THW1/orchid-pot/examples/orchid_box.stl

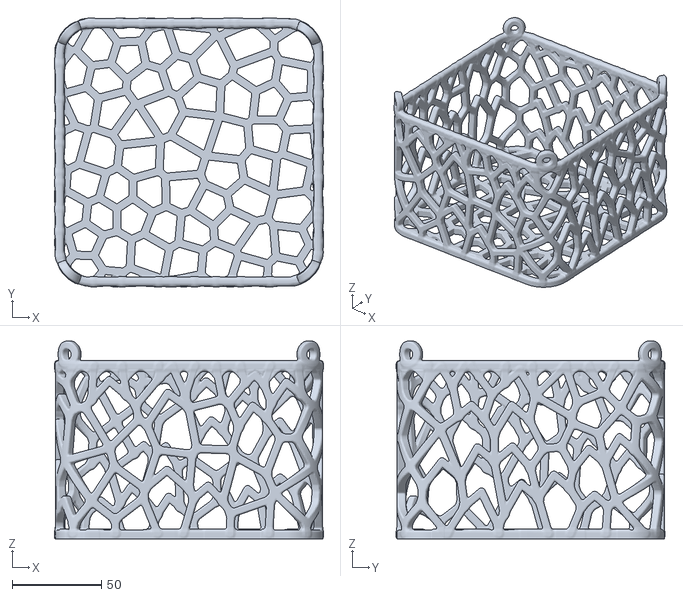
[picture p3: CAD file, 2026-10-25]
examples/orchid_box.stl
150.9 x 150.8 x 111.0
