THW1/orchid-pot/examples/orchid_cylinder_membrane.stl

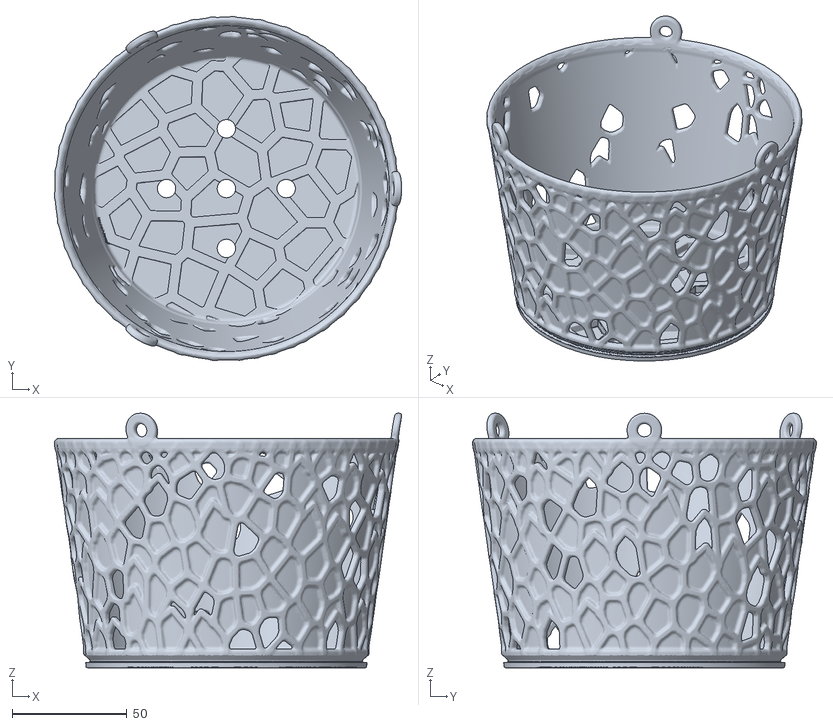
[picture p4: CAD file, 2026-10-25]
examples/orchid_cylinder_membrane.stl
151.4 x 149.9 x 110.9
