THW1/orchid-pot/examples/orchid_cylinder_membrane_tray_clip.stl

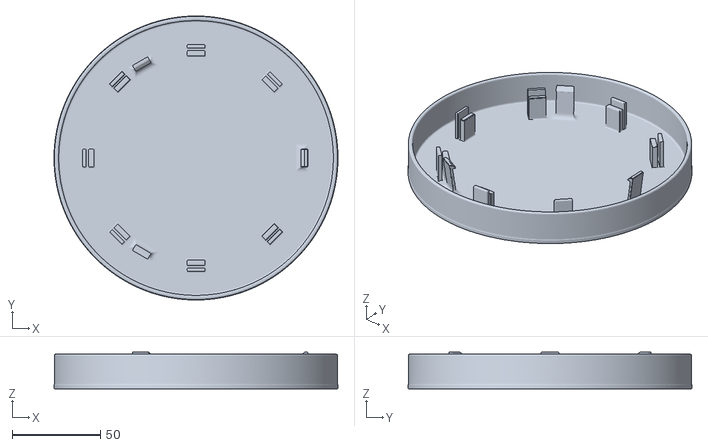
[picture p5: CAD file, 2026-10-25]
examples/orchid_cylinder_membrane_tray_clip.stl
161.3 x 161.3 x 20.9
