THW1/orchid-pot/(commit log)

2026-10-15 Add Voronoi orchid basket generator (v4)
    Parametric generator for a printable Vanda-style hanging orchid basket
    (PETG, 0.4 mm nozzle, printed upright without supports): planar Voronoi
    walls and floor, node lifting, pointed arches, graded cells and grown rim
    gussets against slicer cantilever warnings. Includes the Blender preview
    renderer, README, CONTEXT.md, the current STL/report/previews and the
    archived v2 3D-lattice variant.
2026-10-17 Add cylinder shape with optional taper; shape subcommands
    - CLI: shapes are subcommands (box, cylinder); shared options in a parent
    parser grouped as common / details / printability / mesh.
    - Frames: BoxFrame (rounded square, unchanged v0.4.0 math) and ConeFrame
    (cylinder or cone frustum, --taper in degrees, chart u = theta * r_ref
    with local metric factors). The pipeline only uses the frame interface.
    - --eyelets N (0 = standing pot; box default 4, cylinder default 3).
    - Taper metric taken at a strut's lower end in both lift and classify
    (a mismatch removed 34 nodes at -8 deg).
    - Fill sub-mm^3 enclosed voids after marching cubes (seen with tapers).
    - Default output prefix orchid_<sh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
2026-10-17 Move shape-independent helpers into potlib.py (no output change)
    Pure move of SDF primitives, Poisson seeding, segment distances, Grid,
    wall_metrics, floor_segments, meshing and all checks, plus the former
    main() tail as potlib.finish(). Prepares the experimental orb shape to
    reuse them without touching the box/cylinder pipeline.
    Verified: tests/ pass (box, cylinder, cylinder --taper 8 byte-identical).
2026-10-17 Add experimental orb shape (onion) in its own module
    - orb.py: vertically stretched ellipsoid cut where the wall angle reaches
    --min-wall-angle (default 55 deg), --stretch 1.2, --diameter 150.
    SphericalVoronoi pattern with mirrored seeds at the band/rim latitudes,
    printability on true 3D angles (meridian lift, arches, clash check),
    shell SDF via projection onto the meridian ellipse, rim gussets grown
    per voxel slice, stability check (tip-over angle).
    - orchid_pot.py: `orb` subcommand, imported lazily; --height/--zstretch
    now only for box/cylinder (derived for the orb). No output change for
    box/cylinder (tests pass byte-identical).
    - potlib.finish(): optional extra_checks hook.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
2026-10-17 Fix review findings 1-5, 7-10 (no box/cylinder output change)
    H1 orb: mirror only seeds whose polar-angle image stays beyond its anchor
    latitude; images wrapped over the pole pinned interior vertices to the
    band/rim line (--stretch 1.4 --min-wall-angle 50: 134 -> 42 anchor
    edges, 2 -> 0 removed nodes, max opening height 60 -> 40.5 mm).
    M2 all: --grade-top 0 now really disables grading (formula inverted for
    an empty range and shrank every cell; box: 511 -> 207 nodes).
    M3 orb: floor clipped at the wall's outer face (was mid radius): closes
    the ~0.85 mm groove at the floor/wall joint (+292 mm^2 at z = 4.5).
    M4 orb: arch clash test samples legs at 1 mm and exempts per leg.
    M5 CLI: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
2026-10-17 Merge rim gussets without shifting existing surfaces (review finding 6)
    The gusset SDF was built from all grown material (gusset + struts) and
    min-merged, so inside the struts the voxel/pixel-quantized field replaced
    the smooth one and pushed every surface in the rim zone ~0.2 mm outward
    (the staircase texture under the rim). Now:
    - SDF of the added gusset material only (inside the struts it is >= +1 px,
    so the smooth strut field is kept),
    - 1-voxel Gaussian blur against 1-voxel slivers/pinches where two gusset
    fronts meet (they produced a second body after STL export),
    - smooth union with the strut fillet (a hard min left creases that broke
    the decimation).
    Applies to box/cylinder (2D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
2026-10-17 Finalize code context for v0.6.1 (comments and CONTEXT.md only)
    - Unit context blocks: potlib.finish, orb.orb_graph, orb.grow_rim_gussets;
    orchid_pot.wall_pattern block extended with the shared gusset merge rule.
    - Stale header statements updated (potlib no longer a pure move; orb now
    lives in orb.py; box byte-identity held until the intended v0.6.1 change).
    - CONTEXT.md: gusset rule coupling and shared potlib helpers.
    Reference check: 21 file::symbol references, all resolve. Tests pass.
2026-10-17 Add accessories module with drip tray (saucer) for all shapes
    - accessories.py (separate module, pot pipelines untouched): tray from the
    pot's vertical projection (widest outline; orb: belly) + gap, 2.4 mm
    wall, 2 mm floor, 8 feet under the solid bottom band with outer stops
    (1 mm side clearance, offset by the band's lean), water line 1 mm below
    the pot bottom. Reads pot geometry read-only via TrayGeometry adapters.
    - CLI: --parts pot,tray (accessories only: ~5 s, no pot rebuild), --tray,
    --tray-gap, --tray-wall, --tray-floor, --standoff, --tray-rise.
    - Defaults: box 117 ml / 87 g, cylinder 93 ml / 72 g, orb 92 ml / 73 g;
    all watertight, 1 body, 0 islands, no cantilevers.
    - Fit v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
2026-10-17 Add clip-on tray for hanging pots; STL round-trip check
    - accessories: --tray clip. Flexible arms beside the bottom band, hooks
    over the band top into lattice gaps found from the pot's strut paths
    (main passes wall_graph/orb_graph output for the same seed). Hook reach
    measured past the band's edge rounding (1.5 mm in the wall normal,
    1.5*band_w/wall horizontally) onto the flat top; catch face above the
    real band top (band/floor smooth-union bulge measured 5.46-5.72 mm).
    Standoff auto-chosen for <= 2 % arm strain (box/cylinder 9.9, orb 11.1).
    Feet next to clips dropped; tray gap widened if the arm could not flex.
    Output: <out>_tray_clip.stl (saucer keeps <out>_tray.stl, unchan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
2026-10-17 Match accessories to their pot: fingerprints, automatic fit check, --from-report
    - potlib.fingerprint: 'shape' (outline/band parameters) and 'pattern' (hash
    of the strut paths, 1 um) written into pot and tray reports.
    - accessories.fit_checker: if the pot STL/report sit next to the tray,
    compare fingerprints, then mesh-intersection fit check (seated: no
    overlap; clip: all hooks engage at 1.5 mm lift). Mismatch -> error exit
    with a --from-report hint; missing pot -> skipped and noted.
    - --from-report REPORT: take all pot parameters (and --out) from a pot's
    report; accessory and run options stay from the CLI.
    - potlib.export_safe: if the float32 STL round trip breaks a mesh (box
    --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
2026-10-17 Add planter (closed outer pot; orb: bowl) to accessories
    - --parts planter: inner wall = insertion envelope (widest pot outline
    below each height) + --planter-gap 8, wall 2.4 mm normal to the wall,
    floor 2 mm, feet under the band (6 mm standoff, 5 mm reservoir), 4
    centring ribs (1 mm clearance, 45 deg lead-in). Box/cylinder flush with
    the pot rim; taper < 0 automatically a straight cylinder; orb: bowl up to
    the belly. Optional --planter-eyelets for hanging planters.
    - Fit check extended: seated no overlap + sliding-in test (no overlap at
    10/30/60 mm above the seated position). All pass: box, cylinder, taper
    +8 and -8 (via --from-report), orb bowl; box with 4 eyelets.
    - Measured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
2026-10-17 Fix review findings M1-M4, L5-L10 and minor notes (accessories)
    M1 fit check uses the exact pot height (rounded report value made a
    correct tray fail: --tray-floor 1.25 -> 8.44 mm^3 false overlap).
    M2 hook reach from the signed band lean (taper < 0 lost 0.7 mm onto the
    edge rounding); arm placed at the band's widest face below the hook,
    tip at its top edge, snap deflection = difference (taper -8: 2.82 mm,
    standoff auto 12.4, strain 1.99 %).
    M3 clip placement checked against the strut paths over the whole hook
    height (>= 1.5 mm to every strut surface), also without the pot STL.
    M4 fit check counts engaged clips per clip (pieces -> nearest clip).
    L5 band-top allowance derived fr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
2026-10-17 Planter wall default 2.4 -> 2.0 mm
    2.0 mm is ~5 lines at 0.42 mm, the upper end of the 4-5 perimeters
    recommended for watertight PETG walls. Weights: box 290 -> 256 g,
    cylinder 245 -> 215 g, orb bowl 147 -> 130 g; reservoirs unchanged.
    All three planters: watertight after STL round trip, 1 body, 0 islands,
    fit check ok (seated + sliding in). Tests pass.
2026-10-17 Finalize code context for v0.8.1 (comments, CONTEXT.md, one shared constant)
    - Unit context blocks: accessories.TrayGeometry, place_clips, fit_checker;
    potlib.fingerprint; orchid_pot.apply_report.
    - CLIP_LIP_H replaces the hook height literal used twice (place_clips
    clearance check, tray_sdf geometry); output-neutral (clip trays
    byte-identical).
    - CONTEXT.md: adapter/hook-region/prefix relationships; Verified-at.
    - README: cylinder clip-tray figures (171 ml / 84 g) after re-placement.
    Reference check: 34 file::symbol references, all resolve.
2026-10-18 Refuse ignored accessory options; play-based clip lift test
    A run with --clip-* but the default --tray saucer silently built a tray
    without clips (reported from a real print). Now:
    - --clip-* without --tray clip / tray in --parts, --tray-* without tray,
    --planter-* without planter, --standoff without tray/planter: error.
    - --clip-hook longer than the flat band top is refused (wall 4: max 1.0;
    a 3 mm hook would have passed the band's inner edge, 4.5 mm deflection).
    - Fit check lifts by the hook's vertical play + 0.75 mm instead of a fixed
    1.5 mm (false failure with --clip-clearance 1, play 1.75 mm); report
    field clip_vertical_play_mm.
    - A failing part no longer stops the others; the r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
2026-10-18 Place clips jointly as an evenly spread set with a minimum spacing
    Each clip used to take its nearest free position on its own (only 2 clip
    widths apart), so two clips could end up ~10 deg apart (seen on a print).
    Now the evenly spaced clip set is rotated as a whole; every clip snaps to
    the nearest free position within a tolerance that grows until all fit,
    capped so neighbours stay >= 75 % of the even spacing apart. Box keeps the
    side centres as preferred rotation. Clear error with hints if impossible.
    Measured (7 seeds each): cylinder min spacing 115.4-119.8 deg (was
    92.5-117.4), orb 116.4-119.5 (was 100.4-116.9), box 85.8-89.4 of 90 (was
    80.8-85.7). Repo clip trays and the user's paramete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
2026-10-18 Add continuous snap groove (--clip-groove) and stronger clip arms
    Pot option --clip-groove: continuous groove in the bottom band (band 8 mm
    unless --band; 1.5 mm deep, 3 mm opening; flat floor snapped to a layer
    boundary as the catch face, 45 deg ceiling as lead-in; potlib
    groove_geometry/groove_sdf shared by pots and tray). Off by default: all
    pot outputs unchanged (goldens byte-identical).
    Clip tray in groove mode: clips exactly even (lattice irrelevant), default
    width 10 mm, arm follows the band at --clip-clearance (orb lean too),
    vertical play = clearance (0.3 vs ~1.05 mm), shape-only fingerprint.
    Both modes: 3 mm root fillet (a printed clip broke at its 0.5 mm root)
    and --clip-strain (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
2026-10-18 Add --wall-style solid: plain closed pots with drainage holes
    Pot option for ordinary plants (box, cylinder, orb): solid wall and floor
    (default 2.4 mm; 3.2 with --clip-groove so the groove leaves wall),
    --drain-holes (default 5) / --drain-dia (8 mm), no strut graph. Wall and
    band/rim are joined with a hard union in solid mode: the smooth union of
    coinciding surfaces pushed the face out by k/4 (0.4 mm ridge at band and
    rim; a groove clip touched it). The wall stops half a rim below the top so
    the rim keeps its rounded edge.
    Verified: solid box 234 g, cylinder taper 8 162 g, orb 188 g - watertight
    after STL round trip, one body, no islands, no cantilevers; saucer fit ok;
    solid box with --cli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
2026-10-19 Add --vent-slots for solid pots
    Vertical ventilation slots under the rim (box, cylinder, orb) for orchids
    that need more air than house plants: 4 x 25 mm default, 45 deg pointed
    top, apex at the rim bottom, centred between the eyelets, >= 4 mm wall
    between slots. Report gains vent_slots. Verified: box 12 / cylinder taper 8
    10 / orb 9 slots each one body, 0 islands, no cantilevers, n wall pieces in
    a slice through the slots. pytest: 15 passed.
2026-10-23 Add --membrane for Voronoi pots
    Close the Voronoi cells with a thin wall (default 1.2 mm = 3 lines) on the
    inner face plus a floor plate on the underside with drain holes; the struts
    stay as load-bearing relief. --membrane-top ends the membrane below the rim
    so the top cells stay open for ventilation. The membrane half-space is
    smooth-joined to the struts, then cut flat at the inner face (no k/4 bulge).
    finish() now fills enclosed voids that decimation closes off (orb: one of
    1.3 mm^3); single-shell meshes are untouched.
    Verified: box / cylinder taper 8 top 75 / orb each one body, 0 islands, no
    cantilevers; membrane measured 1.20-1.22 mm; floor plate with 5 holes;
    goldens byte-identical. py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
2026-10-23 Fix groove clip fit on membrane pots
    The membrane floor plate shares its dfoot + 1 edge with the lattice floor;
    their smooth union pushed the band face out > 0.2 mm, so groove clip arms
    (clearance 0.2) overlapped the pot (fit check 1.2 mm^3). Hard union now, in
    build_sdf and build_orb_sdf; band face matches the no-membrane pot within
    0.01 mm and the reported case fits (overlap 0.0, 4/4 clips).
    Mesh tail: silence trimesh divide-by-zero warnings on zero-volume slivers,
    do not count slivers as voids, drop stats of rejected decimation candidates.
    pytest: 17 passed.
2026-10-24 Thicken the groove band inward for thin walls
    With --clip-groove the bottom band grows inward to --groove-depth + 1.5
    (or --band-wall, within [--wall, --wall + 2]) instead of capping the groove
    at --wall - 1.5. The outer face stays flush, so trays and planters fit
    unchanged; band_wall enters the fingerprint only when thicker than --wall.
    Verified (wall 2.5, groove 2.0): box, orb and solid tapered cylinder each
    one body, 0 islands, clip reach 1.8 mm (was capped at 0.8), fit check ok;
    mesh: groove floor 2.0 deep, band 3.5, wall above 2.5.
2026-10-24 Make decimation robust on dense lattices
    Dense pots (--cell 3) failed both decimation attempts and were written
    undecimated (2.6M triangles). Cause: fast_simplification emits
    opposite-facing duplicate triangles (4-fold edges) and, at strong ratios,
    pinches two thin sheets into one edge. Drop all copies of duplicate faces
    and extend the retry ladder to 0.75/0.6/0.5/0.3 of --decimate scaling.
    Accepted meshes of earlier runs are untouched (goldens byte-identical).
    Verified: 90 mm --cell 3 box now decimates at 0.5 (616k vs 1.23M
    triangles), watertight after the STL round trip. pytest: 18 passed.
2026-10-24 Add --membrane-open for partially open membrane walls
    A seeded share of the wall cells stays open (box, cylinder), the rest is
    closed by the membrane: ventilation spread over the wall with the Voronoi
    look. Cells are labelled on the unrolled chart between band and membrane
    top (periodic seam merged, fragments < 1 mm^2 stay closed); strut pixels
    go to their nearest cell, so the cut edge runs along strut centre lines
    inside solid material (a fixed-distance growth reached across thin struts:
    25 micro-voids, decimation failed). Own random stream: strut pattern
    unchanged. Orb: error (no unrolled chart). Docs and CHANGELOG for v0.13.0.
    Verified: 90 mm box (47/189 open) and tapered cylinder with -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
2026-10-25 Prepare public release: licenses and examples
    Code under MIT (LICENSE), example designs under CC BY 4.0 (examples/LICENSE,
    examples/README.md with the commands that made them). examples/ holds the
    default Voronoi box (byte-identical to the golden box, used by the planter
    test), a membrane cylinder with 25 % open cells and its groove clip tray,
    and two renders shown in the README. Other generated STLs, reports and
    previews are no longer tracked (they stay on disk; .gitignore extended).
    pytest: 19 passed.
